sckzor/RadarProject/Code/USBRadar/build/elf2uf2/tmp/ELF2UF2Build-cfgcmd.txt

cmd='/usr/bin/cmake;-GUnix Makefiles;<SOURCE_DIR><SOURCE_SUBDIR>'
