sckzor/RadarProject/ShoppingLists/MouserShopping.xls

SHOPPING CART
This is not an invoice
11-Oct-22 21:08:52
 | Mouser # | Mfr. # | Manufacturer | Customer # | Description | RoHS | Lifecycle | Order Qty. | Price (USD) | Ext.: (USD)
1 | 652-CR0805JW-512ELF | CR0805-JW-512ELF | Bourns |  | Thick Film Resistors - SMD 5.1K 5% | RoHS Compliant By Exemption |  | 2 | $0.10 | $0.20
2 | 652-CR0805-JW-221ELF | CR0805-JW-221ELF | Bourns |  | Thick Film Resistors - SMD 220OHM 1/8WATT 5% | RoHS Compliant By Exemption |  | 1 | $0.10 | $0.10
3 | 652-CR0805FX-1003ELF | CR0805-FX-1003ELF | Bourns |  | Thick Film Resistors - SMD 100K 1% | RoHS Compliant By Exemption |  | 3 | $0.10 | $0.30
4 | 652-CR0805FX-4992ELF | CR0805-FX-4992ELF | Bourns |  | Thick Film Resistors - SMD 49.9K 1% | RoHS Compliant By Exemption |  | 3 | $0.10 | $0.30
5 | 652-CR0805FX-8451ELF | CR0805-FX-8451ELF | Bourns |  | Thick Film Resistors - SMD 8.45K 1% | RoHS Compliant By Exemption |  | 2 | $0.10 | $0.20
6 | 652-CR0805FX-1023ELF | CR0805-FX-1023ELF | Bourns |  | Thick Film Resistors - SMD 102K 1% | RoHS Compliant By Exemption |  | 2 | $0.10 | $0.20
7 | 652-CR0805FX-7151ELF | CR0805-FX-7151ELF | Bourns |  | Thick Film Resistors - SMD 7.15K 1% | RoHS Compliant By Exemption |  | 2 | $0.10 | $0.20
8 | 652-CR0805FX-1212ELF | CR0805-FX-1212ELF | Bourns |  | Thick Film Resistors - SMD 12.1K 1% | RoHS Compliant By Exemption |  | 1 | $0.10 | $0.10
9 | 652-CR0805FX-6983ELF | CR0805-FX-6983ELF | Bourns |  | Thick Film Resistors - SMD 698K 1% | RoHS Compliant By Exemption |  | 1 | $0.10 | $0.10
10 | 652-CR0805FX-4993ELF | CR0805-FX-4993ELF | Bourns |  | Thick Film Resistors - SMD 499K 1% | RoHS Compliant By Exemption |  | 1 | $0.10 | $0.10
11 | 652-CR0805FX-1001ELF | CR0805-FX-1001ELF | Bourns |  | Thick Film Resistors - SMD 1K 1% | RoHS Compliant By Exemption |  | 2 | $0.10 | $0.20
12 | 652-CR0805FX-1621ELF | CR0805-FX-1621ELF | Bourns |  | Thick Film Resistors - SMD 1.62K 1% | RoHS Compliant By Exemption |  | 1 | $0.10 | $0.10
13 | 652-CR0805FX-1002ELF | CR0805-FX-1002ELF | Bourns |  | Thick Film Resistors - SMD 10K 1% | RoHS Compliant By Exemption |  | 5 | $0.10 | $0.50
14 | 652-CR0805FX-1000ELF | CR0805-FX-1000ELF | Bourns |  | Thick Film Resistors - SMD 100ohm 1% | RoHS Compliant By Exemption |  | 1 | $0.10 | $0.10
15 | 652-CR0805JW-100ELF | CR0805-JW-100ELF | Bourns |  | Thick Film Resistors - SMD 10ohm 5% | RoHS Compliant By Exemption |  | 2 | $0.10 | $0.20
16 | 80-C0805C100J1RAUTO | C0805C100J1RACAUTO | KEMET |  | Multilayer Ceramic Capacitors MLCC - SMD/SMT 100V 10pF X7R 0805 5% AEC-Q200 | RoHS Compliant | New Product | 2 | $0.12 | $0.24
17 | 80-C0805C104K5RACLR | C0805C104K5RAC7411 | KEMET |  | Multilayer Ceramic Capacitors MLCC - SMD/SMT 50V 0.1uF X7R 0805 10% | RoHS Compliant |  | 4 | $0.13 | $0.52
18 | 80-C0805C562K4HAUTO | C0805C562K4HACAUTO | KEMET |  | Multilayer Ceramic Capacitors MLCC - SMD/SMT 16V 5600pF X8R 0805 10% AEC-Q200 | RoHS Compliant |  | 2 | $0.25 | $0.50
19 | 80-C0805C105K4RAC | C0805C105K4RAC | KEMET |  | Multilayer Ceramic Capacitors MLCC - SMD/SMT 16V 1uF X7R 0805 10% | RoHS Compliant |  | 1 | $0.14 | $0.14
20 | 80-C0805C102J2GECTU | C0805C102J2GECTU | KEMET |  | Multilayer Ceramic Capacitors MLCC - SMD/SMT 200V 1000pF C0G 0805 5% | RoHS Compliant |  | 4 | $0.23 | $0.92
21 | 80-C0805C103K5R | C0805C103K5RACTU | KEMET |  | Multilayer Ceramic Capacitors MLCC - SMD/SMT 50V 0.01uF X7R 0805 10% | RoHS Compliant |  | 1 | $0.13 | $0.13
22 | 960-EMPCB.SMAFSTJBHT | EMPCB.SMAFSTJ.B.HT | Taoglas |  | RF Connectors / Coaxial Connectors SMA PCB MOUNT JACK | RoHS Compliant |  | 2 | $3.22 | $6.44
23 | 815-AIMC-0805-15NJT | AIMC-0805-15NJ-T | ABRACON |  | RF Inductors - SMD 15 NH 5% | RoHS Compliant By Exemption |  | 2 | $0.19 | $0.38
24 | 611-OS102011MS2QN1C | OS102011MS2QN1C | C&K Switches |  | Slide Switches .1A @ 12VDC ON-ON | RoHS Compliant |  | 1 | $0.61 | $0.61
25 | 652-3296W-1-104RLF | 3296W-1-104RLF | Bourns |  | Trimmer Resistors - Through Hole 3/8" 100Kohms Sealed Vertical Adjust | RoHS Compliant By Exemption |  | 1 | $3.86 | $3.86
26 | 81-PV36W103C01B00 | PV36W103C01B00 | Bourns |  | Trimmer Resistors - Through Hole 10Kohms 10mm Square 25turn | RoHS Compliant |  | 1 | $1.74 | $1.74
27 | 512-2N7000 | 2N7000 | onsemi |  | MOSFET FET 60V 5.0 OHM TO92 | RoHS Compliant |  | 1 | $0.45 | $0.45
By submitting your order you agree to these terms and conditions. (https://www.mouser.com/saleterms) |  |  |  |  |  |  |  |  | Merchandise: | $18.83
Prices are reflected at the date and time shown. |  |  |  |  |  |  |  |  | Shipping Charge: | $7.99
