sckzor/RadarProject/Antennas/SoupCanMount/AntennaMount.FCStd

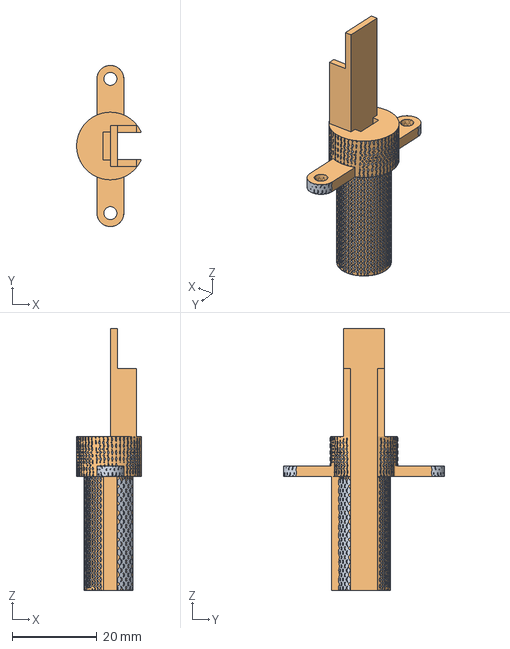
[picture p1: CAD file, 2022-11-01]
Antennas/SoupCanMount/AntennaMount.FCStd
15.3 x 38.0 x 61.7 mm
Body (Meshed)
