sckzor/RadarProject/Antennas/AluminumCut/Antenna.FCStd

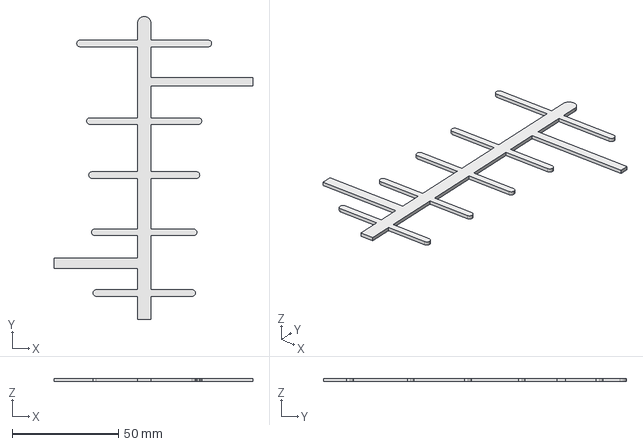
[picture p2: CAD file, 2022-10-12]
Antennas/AluminumCut/Antenna.FCStd
93.3 x 142.4 x 1.59 mm
