sckzor/RadarProject/(list of files, cad)

Other CAD files:
Antennas/AluminumCut/Antenna-Body.step
Antennas/AluminumCut/Antenna-Body.dxf
Antennas/AluminumCut/Antenna-Body.iges
Antennas/SoupCanMount/AntennaMount.stl
