sckzor/RadarProject/AnalogRadar/MkIII/RadarProject.kicad_pcb

## KiCad design AnalogRadar/MkIII/RadarProject.kicad_pcb (2023-01-26)

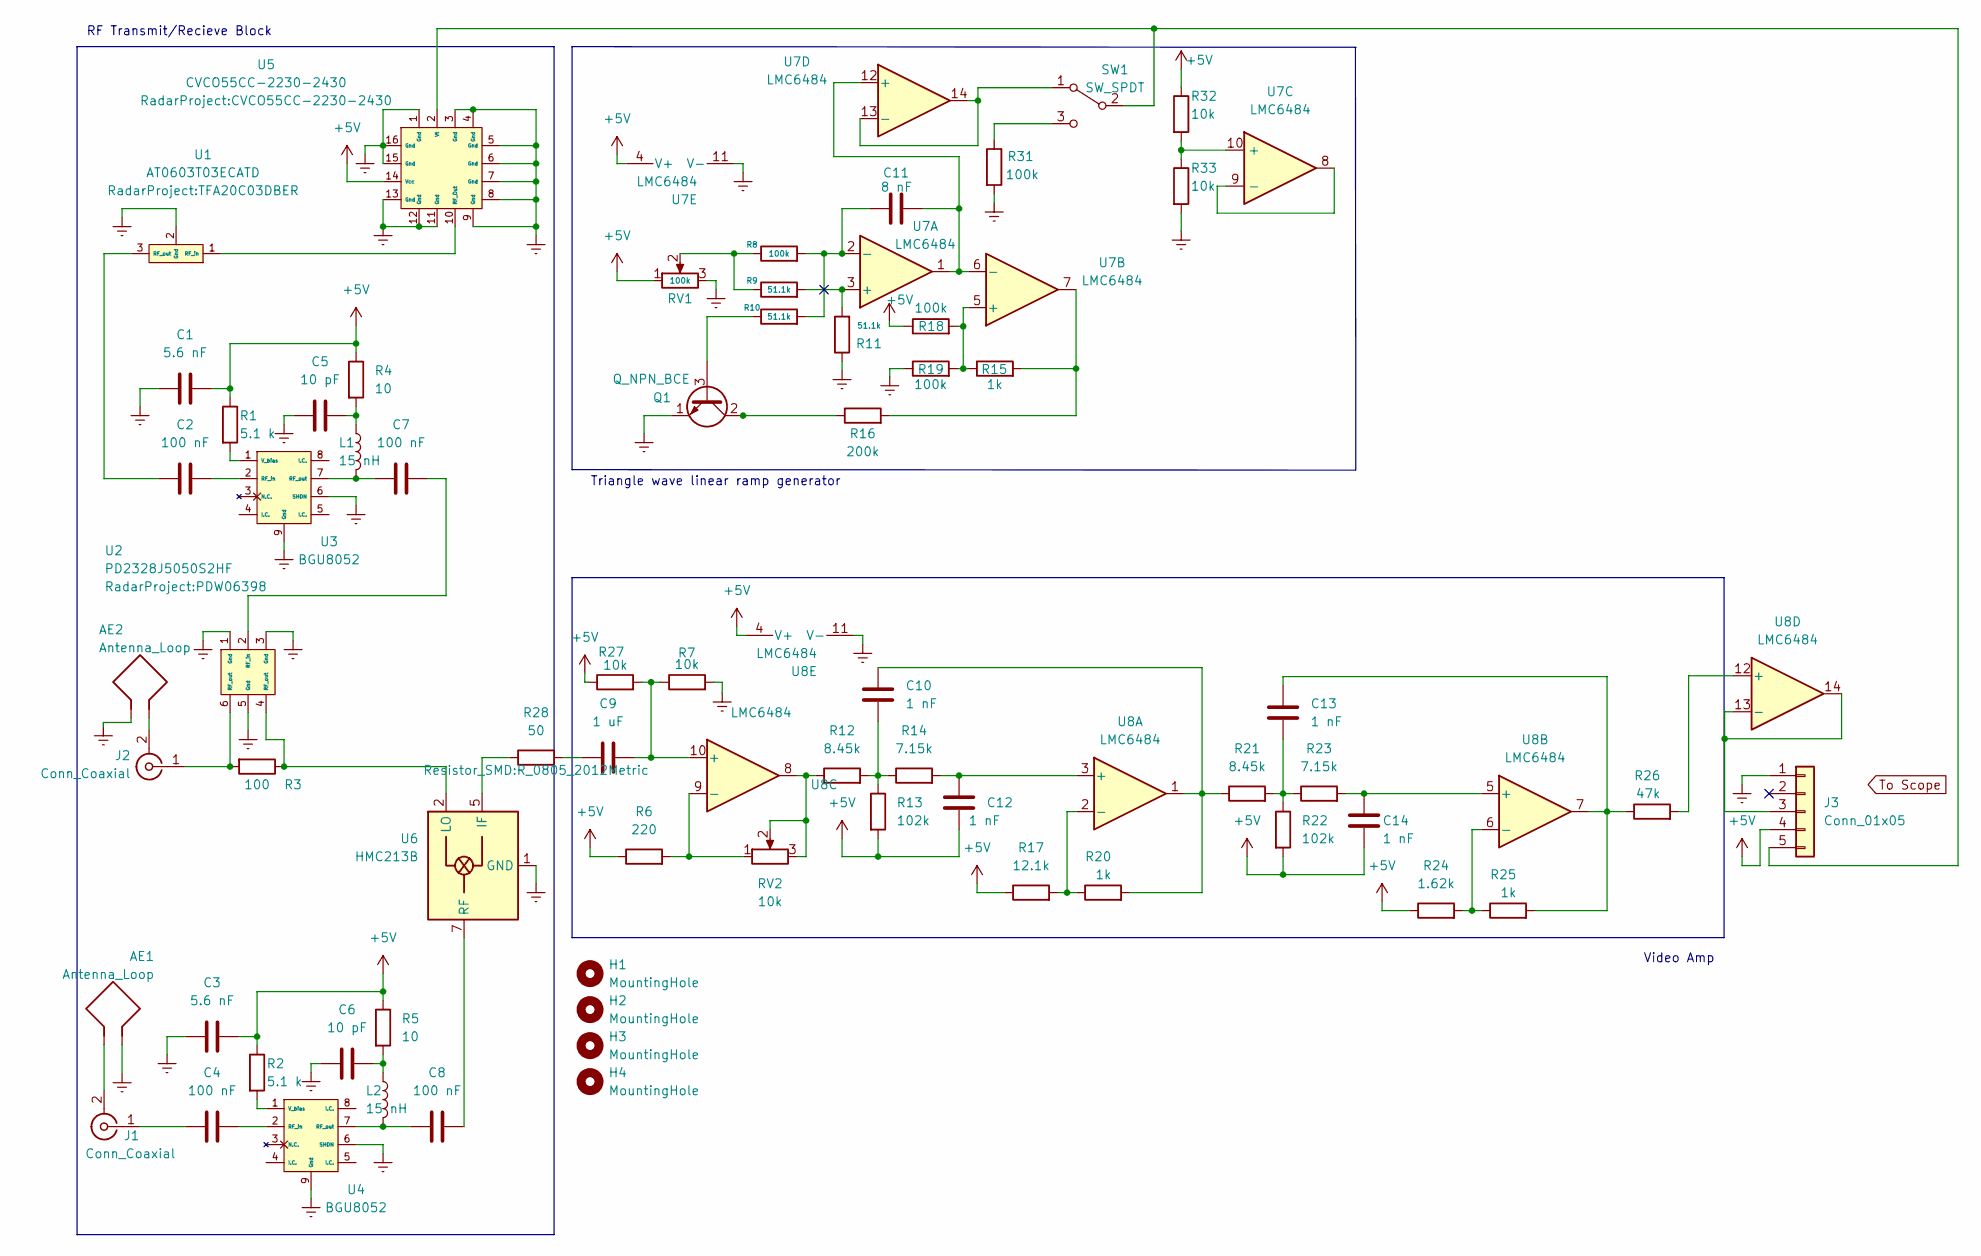
[picture p3: schematic RadarProject.kicad_sch]

Parts:
AE1, AE2: Antenna_Loop
C1, C3: 5.6 nF; C_0805_2012Metric
C2, C4, C7, C8: 100 nF; C_0805_2012Metric
C5, C6: 10 pF; C_0805_2012Metric
C9: 1 uF; C_0805_2012Metric
C10, C12, C13, C14: 1 nF; C_0805_2012Metric
C11: 8 nF; C_0805_2012Metric
H1, H2, H3, H4: MountingHole; MountingHole_2.7mm
J1, J2: Conn_Coaxial; SMA_Samtec_SMA-J-P-X-ST-EM1_EdgeMount
J3: Conn_01x05; PinHeader_1x05_P2.54mm_Vertical
L1, L2: 15 nH; L_0805_2012Metric
Q1: Q_NPN_BCE; TO-92L_Inline
R1, R2: 5.1 k; R_0805_2012Metric
R3: 100; R_0805_2012Metric
R4, R5: 10; R_0805_2012Metric
R6: 220; R_0805_2012Metric
R7, R27, R32, R33: 10k; R_0805_2012Metric
R8, R18, R19, R31: 100k; R_0805_2012Metric
R9, R10, R11: 51.1k; R_0805_2012Metric
R12, R21: 8.45k; R_0805_2012Metric
R13, R22: 102k; R_0805_2012Metric
R14, R23: 7.15k; R_0805_2012Metric
R15, R20, R25: 1k; R_0805_2012Metric
R16: 200k; R_0805_2012Metric
R17: 12.1k; R_0805_2012Metric
R24: 1.62k; R_0805_2012Metric
R26: 47k; R_0805_2012Metric
R28: 50; R_0805_2012Metric
RV1: 100k; Potentiometer_Bourns_3296W_Vertical
RV2: 10k; Potentiometer_Bourns_3296W_Vertical
SW1: SW_SPDT; SW_Slide_1P2T_CK_OS102011MS2Q
U1: AT0603T03ECATD; TFA20C03DBER
U2: PD2328J5050S2HF; PDW06398
U3, U4: BGU8052
U5: CVCO55CC-2230-2430
U6: HMC213B; MSOP-8_3x3mm_P0.65mm
U7: LMC6484; SOIC-14_3.9x8.7mm_P1.27mm
U8: LMC6484

Connections:
+5V: C1.2, C3.2, C12.2, C14.2, J3.4, R1.1, R2.1, R4.1, R5.1, R6.1, R13.2, R17.1, R18.1, R22.2, R24.1, R27.1, R32.1, RV1.1, U5.14 (Vcc), U7.4 (V+), U8.4 (V+)
Earth: AE1.1, AE2.1, C1.1, C3.1, C5.1, C6.1, J1.2 (Ext), J2.2 (Ext), J3.1, Q1.1 (E), R7.2, R11.1, R19.1, R31.2, R33.2, RV1.3, U1.2 (Gnd), U2.1 (Gnd), U2.3 (Gnd), U2.5 (Gnd), U3.6 (SHDN), U3.9 (Gnd), U4.6 (SHDN), U4.9 (Gnd), U5.1 (Gnd), U5.3 (Gnd), U5.4 (Gnd), U5.5 (Gnd), U5.6 (Gnd), U5.7 (Gnd), U5.8, U5.9 (Gnd), U5.11 (Gnd), U5.12 (Gnd), U5.13 (Gnd), U5.15 (Gnd), U5.16 (Gnd), U6.1 (GND), U6.3 (GND), U6.6 (GND), U6.8 (GND), U7.11 (V-), U8.11 (V-)
unnamed: AE1.2, J1.2 (Ext)
unnamed: AE2.2, J2.2 (Ext)
unnamed: C2.1, U1.3 (RF_out)
unnamed: C2.2, U3.2 (RF_in)
unnamed: C4.1, J1.1 (In)
unnamed: C4.2, U4.2 (RF_in)
unnamed: C5.2, L1.1, R4.2
unnamed: C6.2, L2.1, R5.2
unnamed: C7.1, L1.2, U3.7 (RF_out)
unnamed: C7.2, U2.2 (RF_in)
unnamed: C8.1, L2.2, U4.7 (RF_out)
unnamed: C8.2, U6.7 (RF)
unnamed: C9.1, R28.2
unnamed: C10.1, R20.2, R21.1, U8.1
unnamed: C10.2, R12.2, R13.1, R14.1
unnamed: C11.1, R8.2, R10.2, U7.2 (-)
unnamed: C11.2, U7.1, U7.6 (-), U7.12 (+)
unnamed: C12.1, R14.2, U8.3 (+)
unnamed: C13.1, R25.2, R26.1, U8.7
unnamed: C13.2, R21.2, R22.1, R23.1
unnamed: C14.1, R23.2, U8.5 (+)
unnamed: J2.1 (In), R3.2, U2.6 (RF_out)
unnamed: J3.3, U8.13 (-), U8.14
unnamed: J3.5, SW1.2 (B), U5.2 (Vt)
unnamed: Q1.2 (C), R16.1
unnamed: Q1.3 (B), R10.1
unnamed: R1.2, U3.1 (V_bias)
unnamed: R2.2, U4.1 (V_bias)
unnamed: R3.1, U2.4 (RF_out), U6.2 (LO)
unnamed: R6.2, RV2.1, U8.9 (-)
unnamed: C9.2, R7.1, R27.2, U8.10 (+)
unnamed: R8.1, R9.1, RV1.2
unnamed: R9.2, R11.2, U7.3 (+)
unnamed: R12.1, RV2.2, RV2.3, U8.8
unnamed: R15.1, R18.2, R19.2, U7.5 (+)
unnamed: R15.2, R16.2, U7.7
unnamed: R17.2, R20.1, U8.2 (-)
unnamed: R24.2, R25.1, U8.6 (-)
unnamed: R26.2, U8.12 (+)
unnamed: R31.1, SW1.3 (C)
unnamed: R32.2, R33.1, U7.10 (+)
unnamed: SW1.1 (A), U7.13 (-), U7.14
unnamed: U1.1 (RF_in), U5.10 (RF_Out)
unnamed: R28.1, U6.5 (IF)
unnamed: U7.8, U7.9 (-)

Notes on the sheet:
RF Transmit/Recieve Block
Triangle wave linear ramp generator
Video Amp

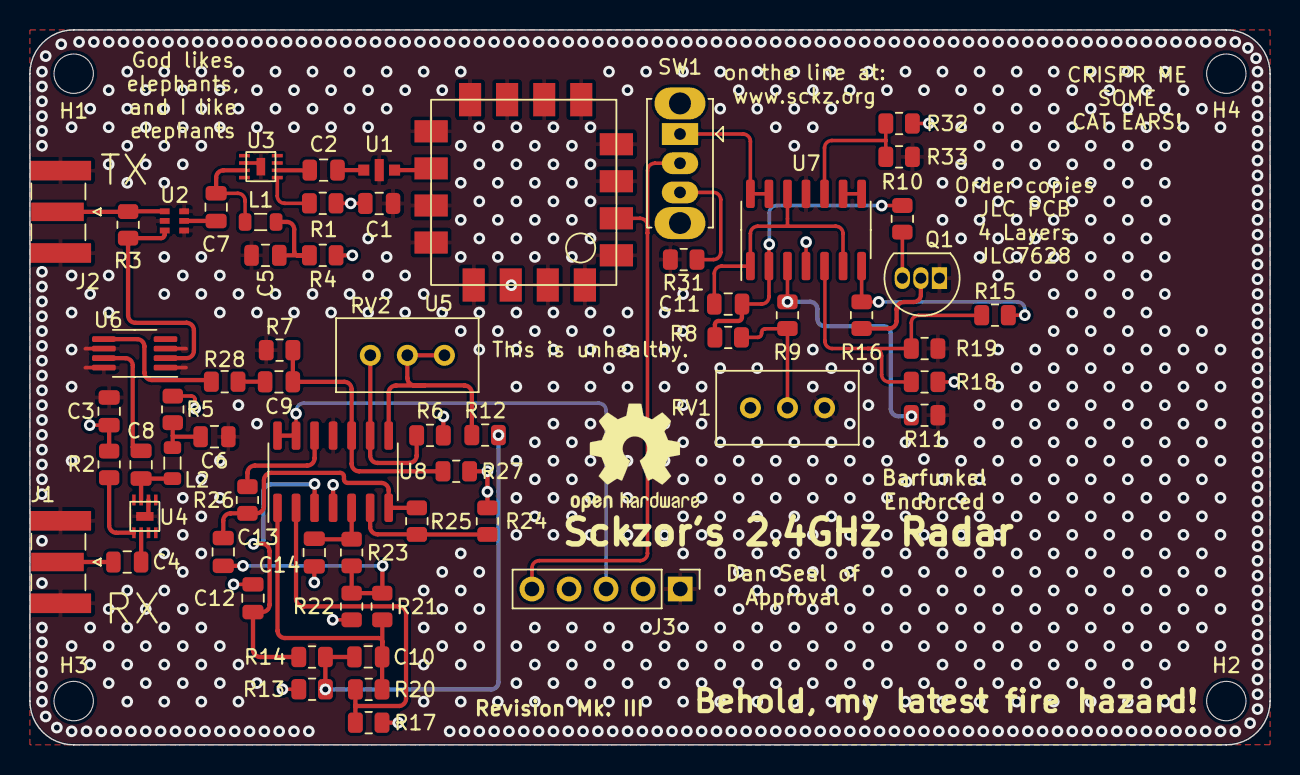
[picture p4: board RadarProject.kicad_pcb from above]

Board: 4 copper layers, 85.0 x 49.0 mm, 66 parts (0 on the bottom side), 45 nets.
