sckzor/RadarProject/PicoBoard/PicoBoard.kicad_pcb

## KiCad design PicoBoard/PicoBoard.kicad_pcb (2022-11-20)

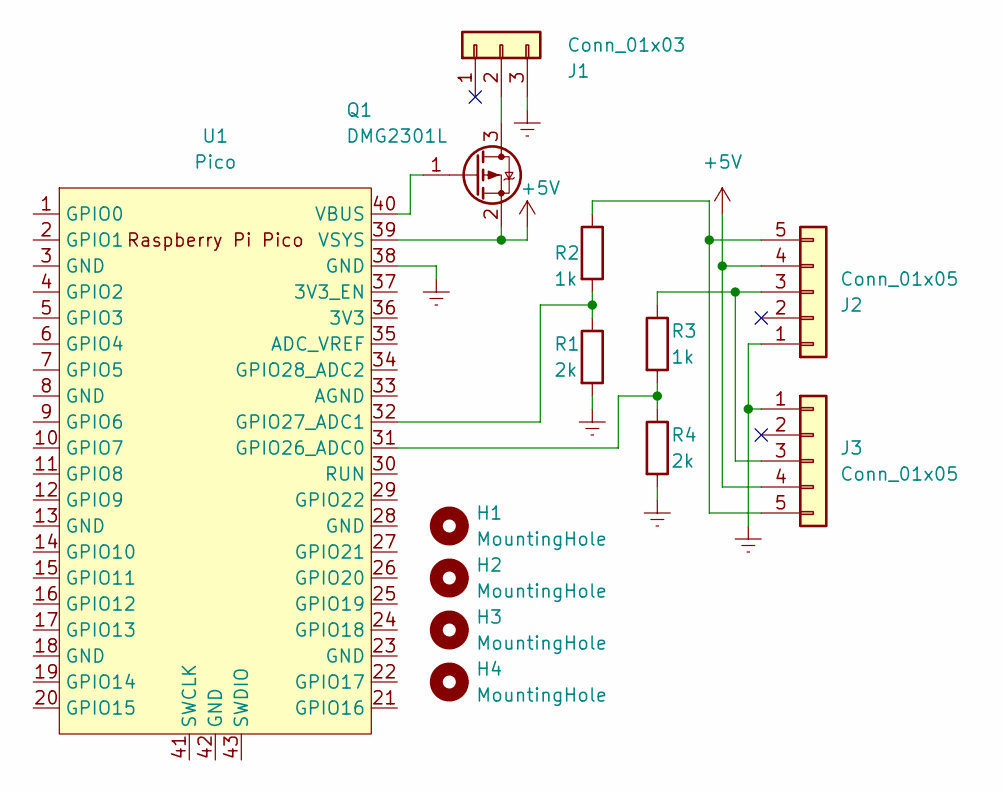
[picture p5: schematic PicoBoard.kicad_sch]

Parts:
H1, H2, H3, H4: MountingHole; MountingHole_2.7mm
J1: Conn_01x03; PinHeader_1x03_P2.54mm_Horizontal
J2: Conn_01x05; PinHeader_1x05_P2.54mm_Vertical
J3: Conn_01x05; PinHeader_1x05_P2.54mm_Horizontal
Q1: DMG2301L; SOT-23
R1, R4: 2k; R_0805_2012Metric
R2, R3: 1k; R_0805_2012Metric
U1: Pico; RPi_Pico_SMD_TH

Connections:
+5V: J2.4, J3.4, Q1.2 (S), U1.39 (VSYS)
Earth: J1.3, J2.1, J3.1, R1.2, R4.2, U1.38 (GND)
unnamed: J1.2, Q1.3 (D)
unnamed: J2.3, J3.3, R3.1
unnamed: J2.5, J3.5, R2.1
unnamed: Q1.1 (G), U1.40 (VBUS)
unnamed: R3.2, R4.1, U1.31 (GPIO26_ADC0)
unnamed: R1.1, R2.2, U1.32 (GPIO27_ADC1)

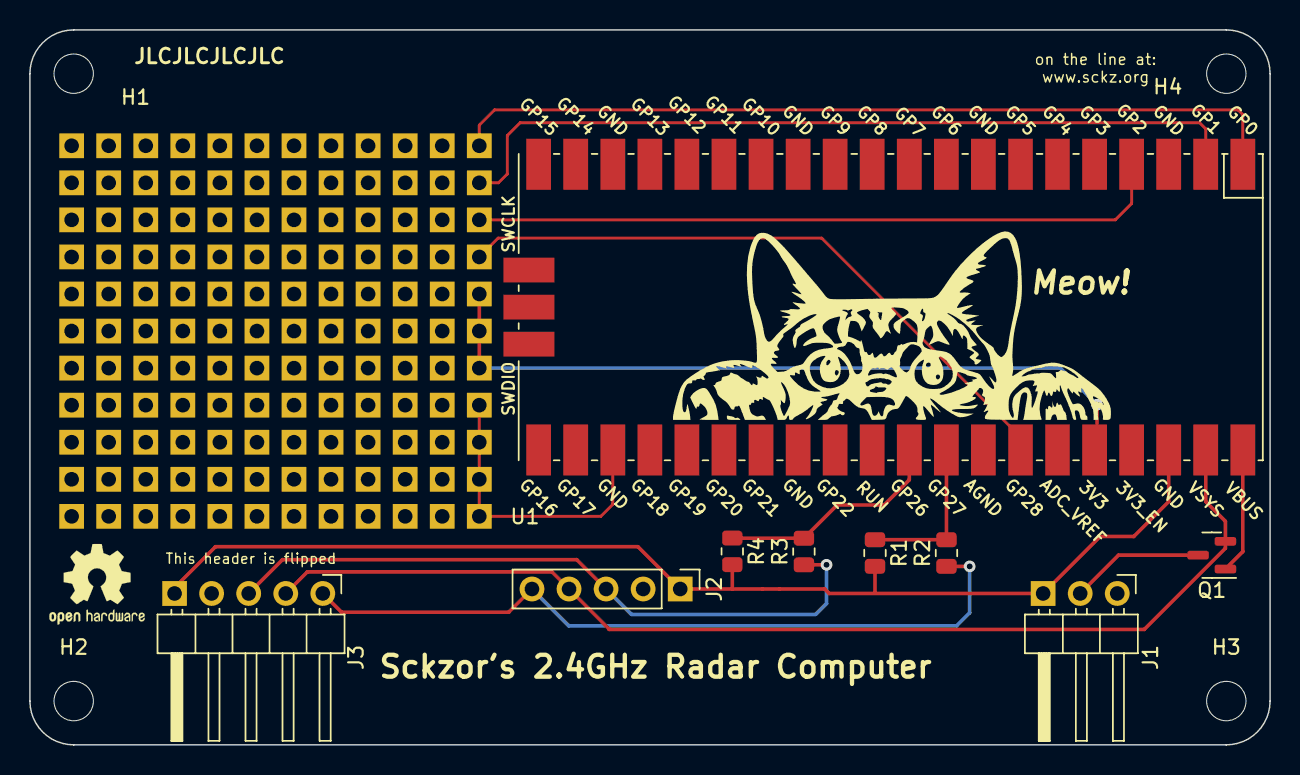
[picture p6: board PicoBoard.kicad_pcb from above]

Board: 2 copper layers, 85.0 x 49.0 mm, 14 parts (0 on the bottom side), 8 nets.

Other parts of the board:
Meow!: LOGO
