sckzor/RadarProject/Code/USBRadar/build/elf2uf2/src/ELF2UF2Build-stamp/ELF2UF2Build-source_dirinfo.txt

# This is a generated file and its contents are an internal implementation detail.
# The download step will be re-executed if anything in this file changes.
# No other meaning or use of this file is supported.

method=source_dir
command=
source_dir=/usr/share/pico-sdk/tools/elf2uf2
work_dir=
