sckzor/RadarProject/(commit log)

2022-09-07 Added all pcb files
    [RadarProject-B_Cu.gbr, RadarProject-B_Mask.gbr, RadarProject-B_Paste.gbr, RadarProject-B_Silkscreen.gbr, RadarProject-Edge_Cuts.gbr, RadarProject-F_Cu.gbr, RadarProject-F_Mask.gbr, RadarProject-F_Paste.gbr]
2022-09-07 Redid directory structure
    [RadarProject-B_Cu.gbr, RadarProject-B_Mask.gbr, RadarProject-B_Paste.gbr, RadarProject-B_Silkscreen.gbr, RadarProject-Edge_Cuts.gbr, RadarProject-F_Cu.gbr, RadarProject-F_Mask.gbr, RadarProject-F_Paste.gbr]
2022-09-11 Final schematic is generally done, just some minor fixes
    [RadarProject.kicad_pcb, RadarProject.kicad_sch]
2022-10-12 Updated PCB, added antennas, etc.
    [Antenna-Body.dxf, Antenna-Body.iges, Antenna-Body.step, Antenna.FCStd, AntennaMount.FCStd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]
2022-10-12 Added shopping lists
    [DigiKeyShopping.csv, MouserShopping.xls]
2022-11-01 Final production PCB
    [AntennaMount.FCStd, AntennaMount.stl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]
2022-11-05 Added Raspberry Pi Pico bare metal code
2022-11-19 new version of PCB
    [RadarProject.kicad_pcb, RadarProject.kicad_sch]
2022-11-19 remade directory structure
    [Antenna-Body.dxf, Antenna-Body.iges, Antenna-Body.step, Antenna.FCStd, AntennaMount.FCStd, AntennaMount.stl, PicoBoard.kicad_pcb, PicoBoard.kicad_sch]
2022-11-19 changed directories more
    [Antennas-B_Mask.gbr, Antennas-B_Paste.gbr, Antennas-B_Silkscreen.gbr, Antennas-Edge_Cuts.gbr, Antennas-F_Cu.gbr, Antennas-F_Mask.gbr, Antennas-F_Paste.gbr, Antennas-F_Silkscreen.gbr]
2022-11-20 added pico carrier board
    [PicoBoard-B_Cu.gbr, PicoBoard-B_Mask.gbr, PicoBoard-B_Paste.gbr, PicoBoard-B_Silkscreen.gbr, PicoBoard-Edge_Cuts.gbr, PicoBoard-F_Cu.gbr, PicoBoard-F_Mask.gbr, PicoBoard-F_Paste.gbr]
2022-11-24 final changes to pcb and code updates
2023-01-12 Added much better grounding an component spacing
    [RadarProject-B_Cu.gbr, RadarProject-B_Mask.gbr, RadarProject-B_Paste.gbr, RadarProject-B_Silkscreen.gbr, RadarProject-Edge_Cuts.gbr, RadarProject-F_Cu.gbr, RadarProject-F_Mask.gbr, RadarProject-F_Paste.gbr]
2023-01-26 Updated PCB designs
    [RadarProject-B_Cu.gbr, RadarProject-B_Mask.gbr, RadarProject-B_Paste.gbr, RadarProject-B_Silkscreen.gbr, RadarProject-Edge_Cuts.gbr, RadarProject-F_Cu.gbr, RadarProject-F_Mask.gbr, RadarProject-F_Paste.gbr]
